WuQinghui-00/STM32F407-DAC8568-ADS1256-PID/stm32f407com.ioc

Mcu.UserName=STM32F407VETx
PA10.Signal=USART1_RX
PA13.Signal=SYS_JTMS-SWDIO
PA14.Signal=SYS_JTCK-SWCLK
PA5.Signal=SPI1_SCK
PA6.Signal=SPI1_MISO
PA7.Signal=SPI1_MOSI
PA9.Signal=USART1_TX
PB10.Signal=GPIO_Output
PB11.Signal=GPIO_Output
PB2.Signal=GPIO_Output
PC14-OSC32_IN.Signal=RCC_OSC32_IN
PC15-OSC32_OUT.Signal=RCC_OSC32_OUT
PC5.Signal=GPIO_Output
PD3.Signal=GPIO_Input
PD4.Signal=GPIO_Output
PD5.Signal=GPIO_Output
PH0-OSC_IN.Signal=RCC_OSC_IN
PH1-OSC_OUT.Signal=RCC_OSC_OUT
